izzy84075/ltx-rapidfire/PCB/parts-mouser.txt

594-K104K15X7RF5UH5 2
581-TAP106K010SCS 1
667-EEU-FM1A471 1
594-K223K15X7RF53L2 1
583-1N4148-T 1
782-TSAL6100 1
517-30306-6002HB 1
610-2N3904 6
610-2N3906 6
512-SS8550DTA 1
660-MOX1CT52RR62J 1
660-MOSX1CT52R3R9J 1
660-MF1/4DCT52R47R0F 1
660-MF1/4DC1000F 1
660-MF1/4DCT52A1500F 1
660-MF1/4DC1001F 3
660-MF1/4DC1301F 1
660-MF1/4DCT52R2201F 1
660-MF1/4DCT52R3301F 1
660-MF1/4DCT52R3901F 1
660-MF1/4DCT52A1002F 2
660-MF1/4DCT52R1602F 1
660-MF1/4DCT52R2202F 3
660-MF1/4DCT52R4702F 4
660-MF1/4DCT52R5102F 2
660-MF1/4DCT52A1003F 1
660-MS1/4DCT52R2003 1
660-MF1/4DCT52R2203F 1
511-LE33CZ-TR 1
692-Z8F082APB020SG 1
