izzy84075/ltx-rapidfire/(list of files, drawings)

Other design files:
PCB/Old/RapidBlast ver 1_3 x2.pcb
