izzy84075/ltx-rapidfire/PCB/LTX-Rapidfire.brd

## EAGLE design PCB/LTX-Rapidfire.brd (2014-10-22)

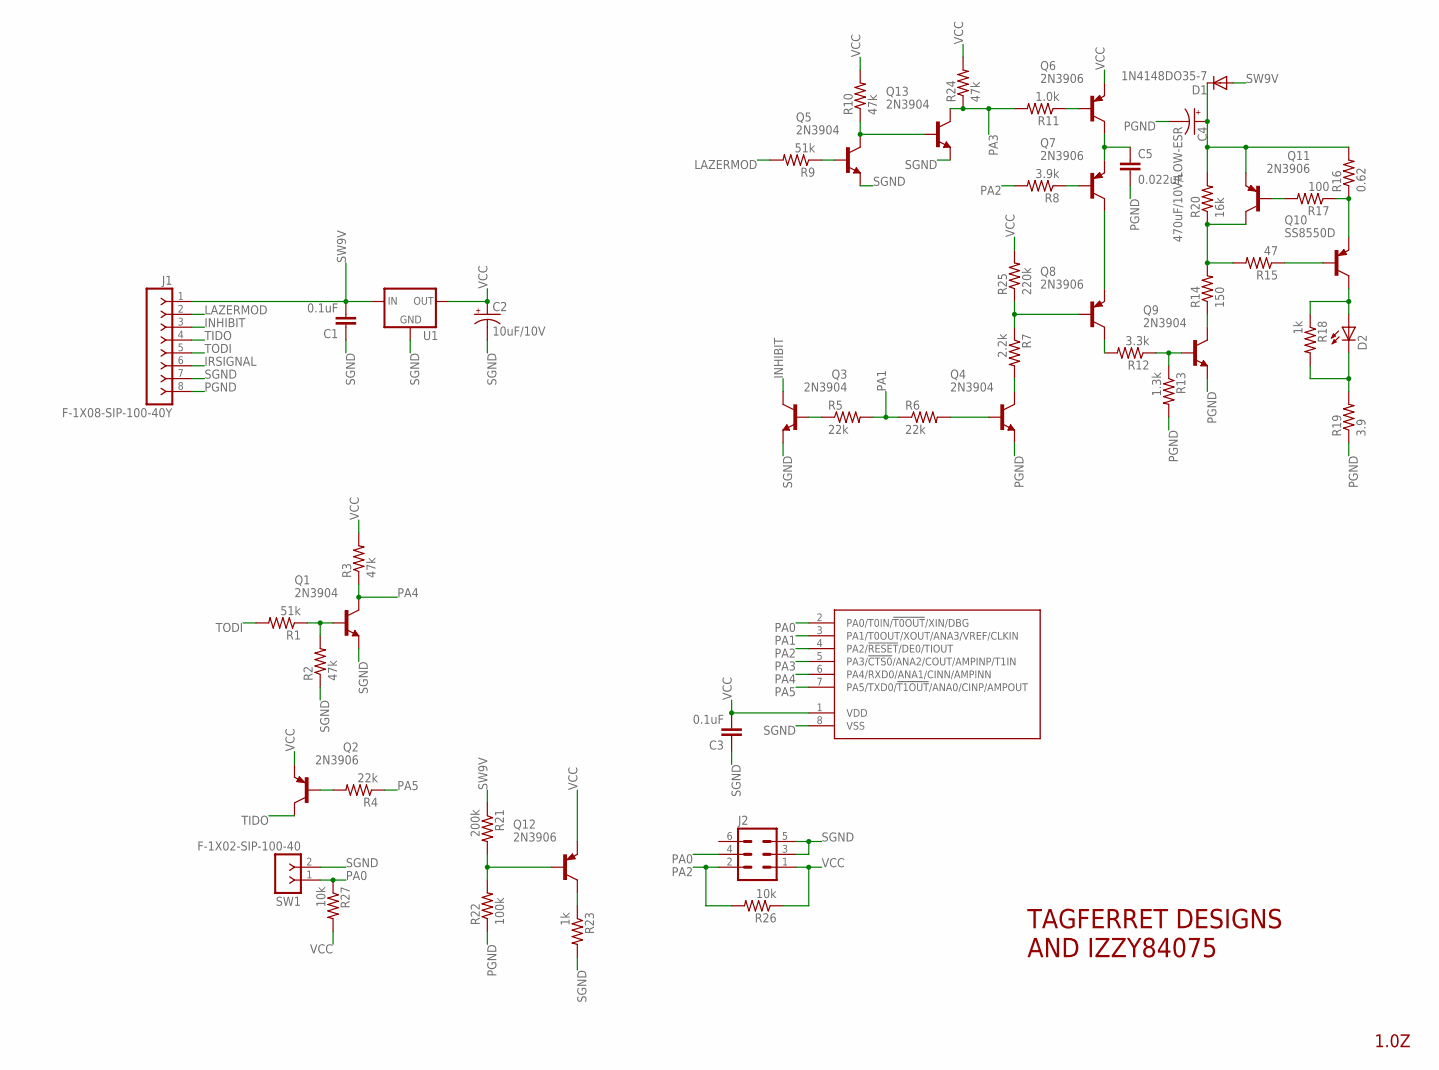
[picture p1: schematic LTX-Rapidfire.sch]

Parts:
C1, C3: 0.1uF; C025-025X050
C2: 10uF/10V; E2-4
C4: 470uF/10V/LOW-ESR; E3,5-8
C5: 0.022uF; C025-025X050
D1: 1N4148DO35-7; DO35-7
D2: LED5MM
J1: F-1X08-SIP-100-40Y; SIP-100-08-40Y
J2: MA03-2
Q1, Q3, Q4, Q5, Q9, Q13: 2N3904; TO92
Q2, Q6, Q7, Q8, Q11, Q12: 2N3906; TO92
Q10: SS8550D; TO92
R1, R9: 51k; 0204/7
R2, R3, R10, R24: 47k; 0204V
R4, R5, R6: 22k; 0204/7
R7: 2.2k; 0204/7
R8: 3.9k; 0204/7
R11: 1.0k; 0204/7
R12: 3.3k; 0204/7
R13: 1.3k; 0204V
R14: 150; 0204/7
R15: 47; 0204/7
R16: 0.62; 0204/7
R17: 100; 0204V
R18: 1k; 0204V
R19: 3.9; 0207/10
R20: 16k; 0204V
R21: 200k; 0204/7
R22: 100k; 0204V
R23: 1k; 0204/7
R25: 220k; 0204V
R26, R27: 10k; 0204V
SW1: F-1X02-SIP-100-40; SIP-100-02-40
U1: 78LXX
U2: Z8F082ADIL-8; DIL8

Connections:
INHIBIT: J1.3, Q3.1 (C)
IRSIGNAL: J1.6
LAZERMOD: J1.2, R9.2
unnamed: Q11.2 (B), R17.2
unnamed: C4.+, D1.C, Q11.3 (E), R16.2, R20.2
unnamed: Q10.3 (E), R16.1, R17.1
unnamed: Q11.1 (C), R14.2, R15.2, R20.1
unnamed: Q10.2 (B), R15.1
unnamed: Q9.1 (C), R14.1
unnamed: D2.K (C), R18.2, R19.2
unnamed: D2.A, Q10.1 (C), R18.1
unnamed: Q9.2 (B), R12.1, R13.1
unnamed: Q8.1 (C), R12.2
unnamed: Q7.1 (C), Q8.3 (E)
unnamed: Q8.2 (B), R7.1, R25.1
unnamed: Q7.2 (B), R8.1
unnamed: Q4.1 (C), R7.2
unnamed: C5.1, Q6.1 (C), Q7.3 (E)
unnamed: Q4.2 (B), R6.2
unnamed: Q12.1 (C), R23.1
unnamed: Q3.2 (B), R5.1
unnamed: Q6.2 (B), R11.1
unnamed: Q12.2 (B), R21.2, R22.2
unnamed: Q5.1 (C), Q13.2 (B), R10.1
unnamed: Q5.2 (B), R9.1
unnamed: Q1.2 (B), R1.1, R2.2
unnamed: Q2.2 (B), R4.2
PA0: J2.4, R27.1, SW1.1, U2.2 (PA0/T0IN/!T0OUT!/XIN/DBG)
PA1: R5.2, R6.1, U2.3 (PA1/T0OUT/XOUT/ANA3/VREF/CLKIN)
PA2: J2.2, R8.2, R26.2, U2.4 (PA2/!RESET!/DE0/TIOUT)
PA3: Q13.1 (C), R11.2, R24.1, U2.5 (PA3/!CTS0!/ANA2/COUT/AMPINP/T1IN)
PA4: Q1.1 (C), R3.1, U2.6 (PA4/RXD0/ANA1/CINN/AMPINN)
PA5: R4.1, U2.7 (PA5/TXD0/!T1OUT!/ANA0/CINP/AMPOUT)
PGND: C4.-, C5.2, J1.8, Q4.3 (E), Q9.3 (E), R13.2, R19.1, R22.1
SGND: C1.1, C2.-, C3.1, J1.7, J2.3, J2.5, Q1.3 (E), Q3.3 (E), Q5.3 (E), Q13.3 (E), R2.1, R23.2, SW1.2, U1.GND, U2.8 (VSS)
SW9V: C1.2, D1.A, J1.1, R21.1, U1.IN
TIDO: J1.4, Q2.1 (C)
TODI: J1.5, R1.2
VCC: C2.+, C3.2, J2.1, Q2.3 (E), Q6.3 (E), Q12.3 (E), R3.2, R10.2, R24.2, R25.2, R26.1, R27.2, U1.OUT, U2.1 (VDD)

Notes on the sheet:
TAGFERRET DESIGNS AND IZZY84075
1.0Z

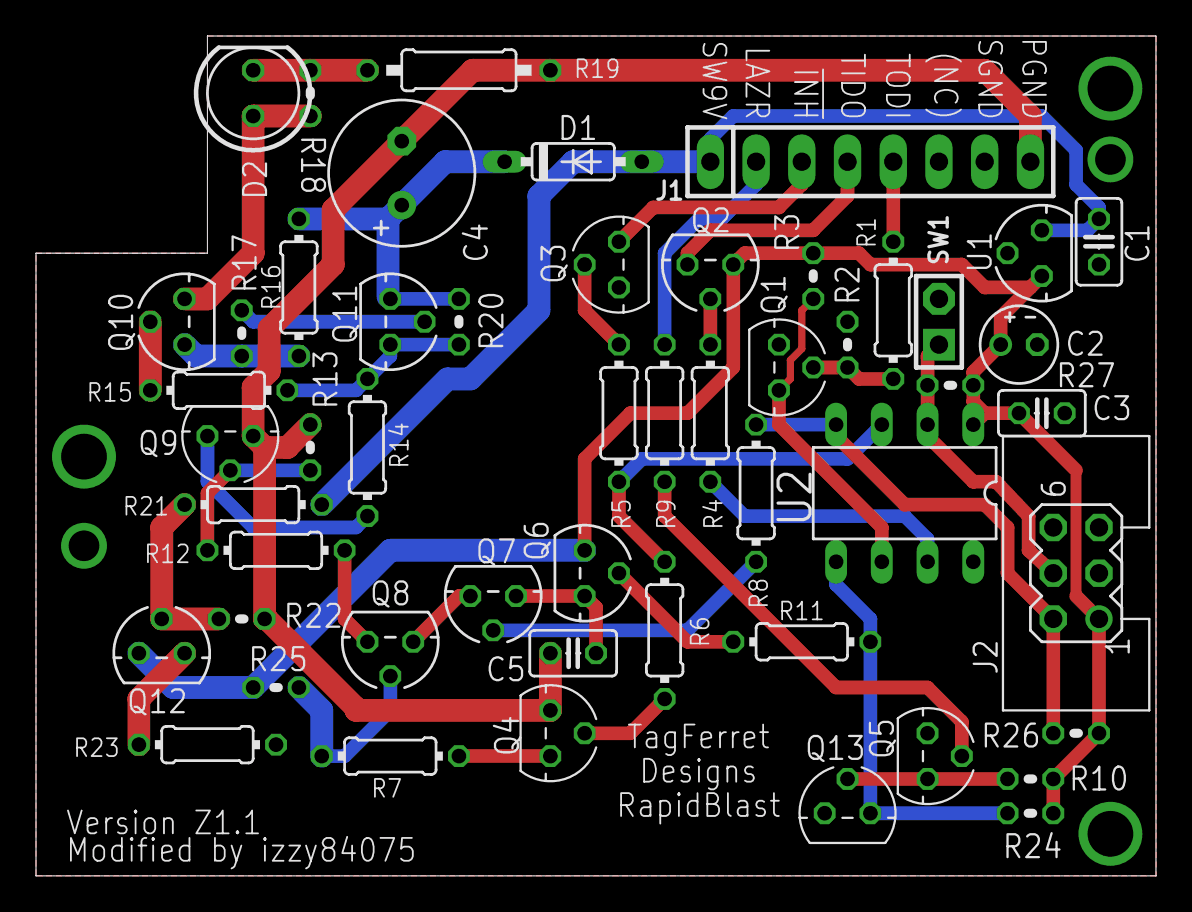
[picture p2: board LTX-Rapidfire.brd from above]

Board: 2 copper layers, 62.2 x 46.7 mm, 52 parts (0 on the bottom side), 38 nets.
