izzy84075/ltx-rapidfire/(commit log)

2013-12-14 Whoops. Didn't have this in Git before... But anyways! This is the code for a DIY LTX-compatible RapidFire(Or whatever other weapon you want) attachment. It works, though there are some enhancements 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
    [main.c]
2013-12-14 And speaking of enhancements, let's make it so that we can choose whether or not to allow reloading the attachment mid-clip. It won't reload when the clip's already full, but it will if you fire a si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
    [main.c]
2013-12-17 Add a ton of comments, clean up a bunch.
    Added comments to almost everything, made more of the weapon details
    configurable from the defines at the top of the file, and fixed up a few
    little things that no longer needed to be where they were.
    [main.c]
2013-12-19 Add .h files
    Split out the function prototypes, global variables, and configuration
    data to their own files, as should have been done long ago. This is
    actually starting to look like a decent project!
2013-12-19 Add some instructions.
    Incomplete as of yet, but I still don't have the PCB schematics or parts
    list to finish the rest of it.
2013-12-19 Take out the temporary TX buffer.
    Also tried updating the "factory test" mode bit, but it doesn't seem to
    work anymore. Not sure why.
    [main.c, main.h]
2014-05-31 Move code into a subfolder in preparation for PCB files.
2014-05-31 Older PCB files. NOBODY ORDER THESE! THEY WILL NOT WORK WITH THE CURRENT CODE! THEY ARE FOR A DIFFERENT PROCESSOR!
    [RapidBlast V1_3.sch, RapidBlast ver 1_3 x2.pcb]
2014-05-31 Starting in on current schematic.
    [LTX-Rapidfire.sch]
2014-05-31 A (hopefully) complete schematic...
2014-05-31 Whoops. Missed some bits. /Now/ it's complete.
    [LTX-Rapidfire.sch]
2014-06-05 First pass of PCB layout is complete.
    Cleanup is in progress, but they should technically work as-is. Labels
    are going to be impossible to see, though.
    [LTX-Rapidfire.brd, LTX-Rapidfire.sch]
2014-06-05 Let's rotate the board so that it fits on my screen better, now that I'm not converting measurements between ExpressPCB and Eagle.
    [LTX-Rapidfire.brd]
2014-06-05 Labels and silkscreen!
    [LTX-Rapidfire.brd, LTX-Rapidfire.sch]
2014-06-05 I suppose making it pass DRC would be good...
    [LTX-Rapidfire.brd]
2014-06-05 Tweaking for OSHPark rendering.
    [LTX-Rapidfire.brd]
2014-06-15 And converted to Mouser's BOM Import format.
2014-06-15 Update the project files to current.
2014-10-06 A resistor got missed! Whoops. Put that back in...
    [LTX-Rapidfire.brd, LTX-Rapidfire.sch]
2014-10-06 Update the partslists to add in that missing resistor.
2014-10-22 Replace R19 out so you can fit a 1/2W resistor in.
    [LTX-Rapidfire.brd, LTX-Rapidfire.sch]
2014-10-22 Replace the special order capacitor with a normally stocked one.
2014-12-11 Update Mouser BOM, to meet their new standard...
2014-12-11 Swap for a different capacitor.
2014-12-22 Update PCB purchase link.
2015-07-24 Add DoubleTap support and documentation, and a couple more configuration options to really take advantage of it!
2015-08-17 An extra #endif snuck into config.h, and an error in the comments for DoubleTaps were pointed out to me. Fix those!
    [config.h]
